shahinshabab/Attendance-Project/docs/tft-screens.png

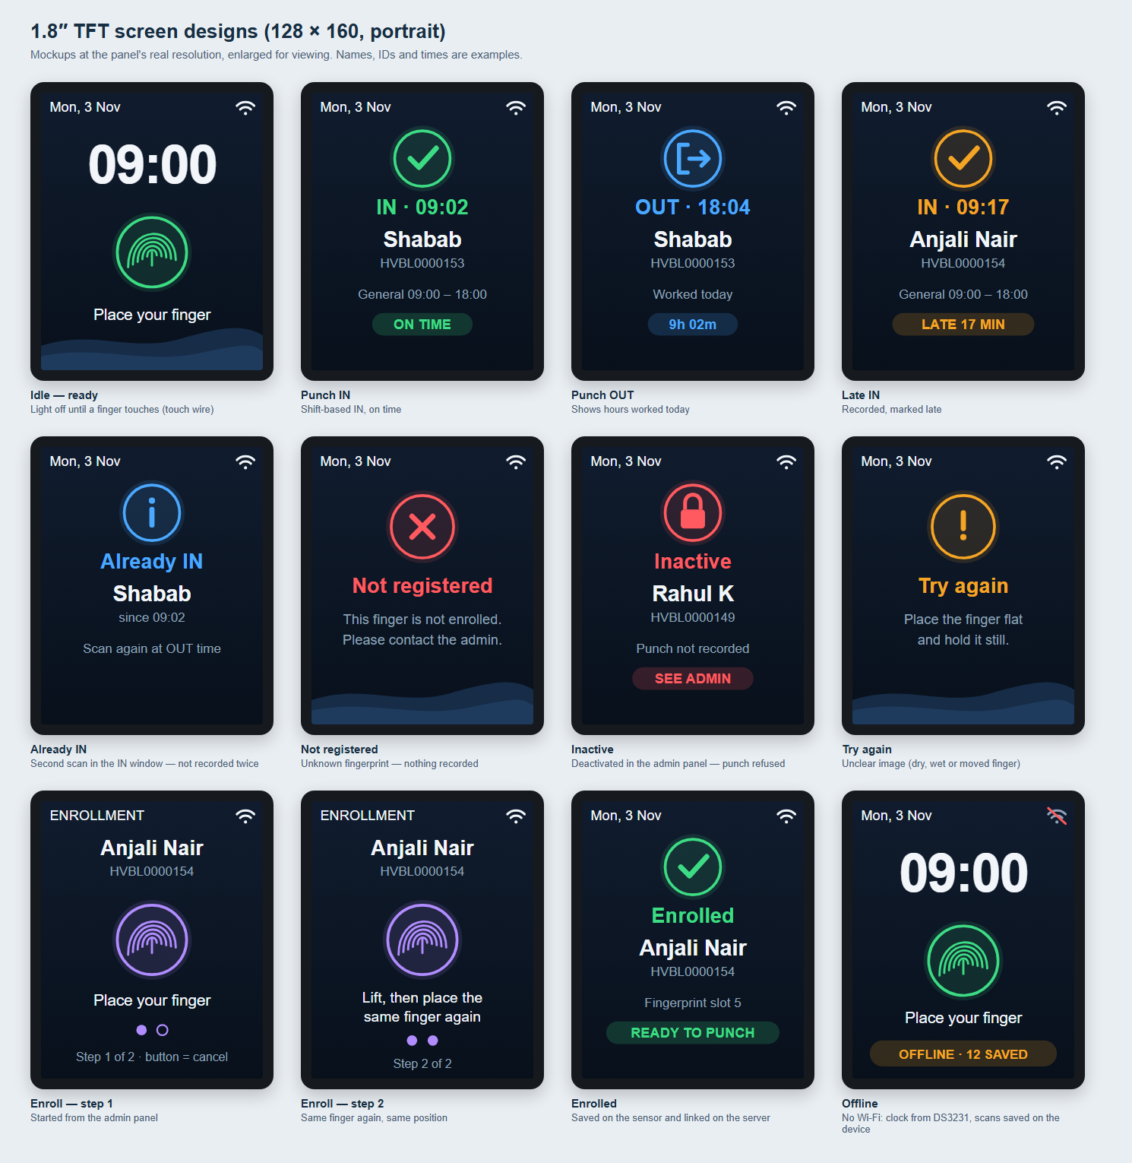
docs/tft-screens.png
