shahinshabab/Attendance-Project/docs/wiring.png

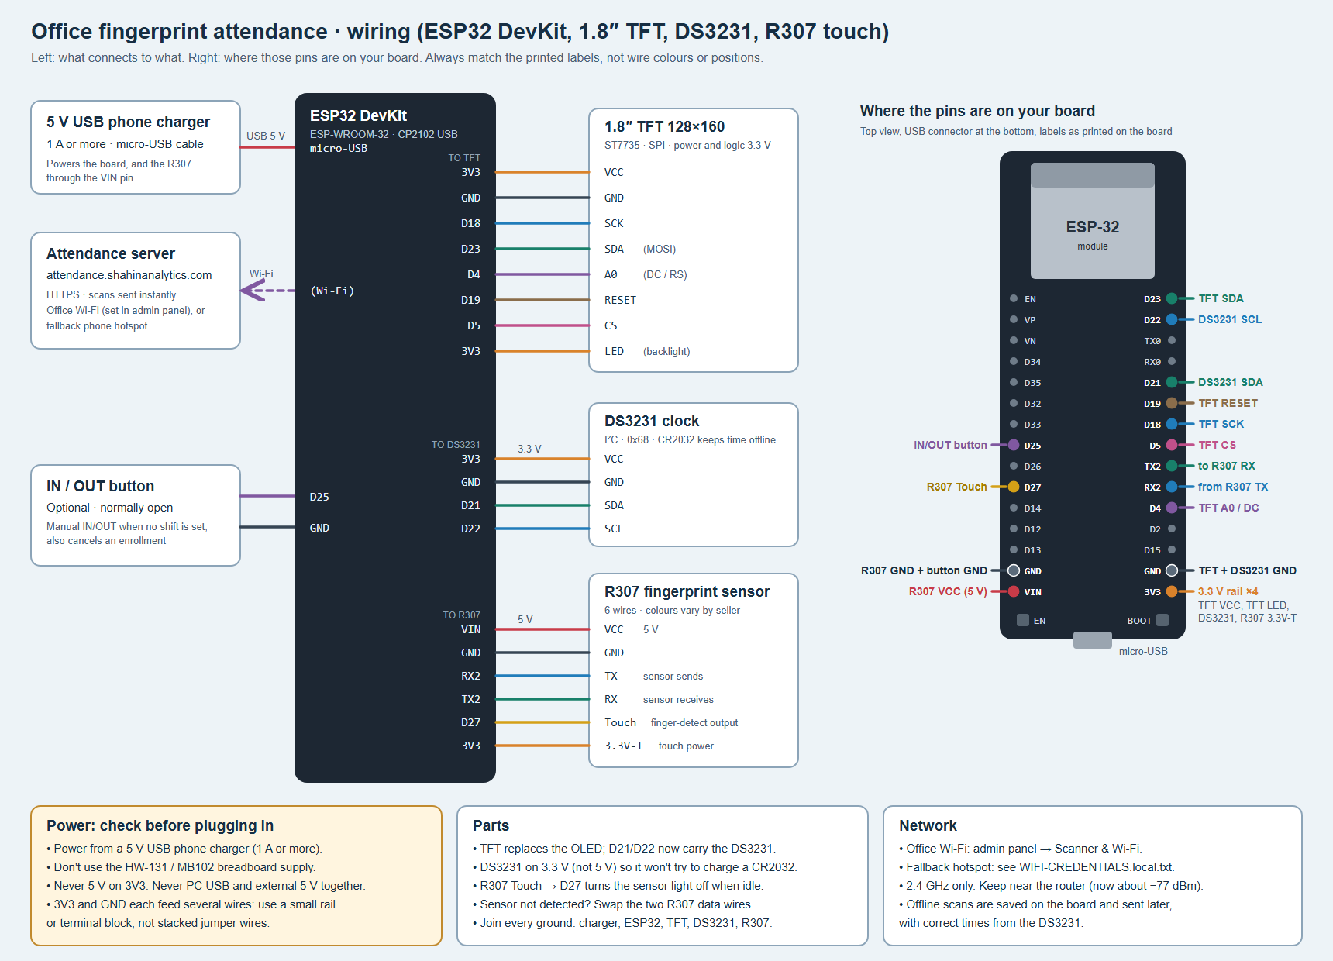
docs/wiring.png
