shahinshabab/Attendance-Project/pcb/attendance-board/attendance-board-schematic.pdf

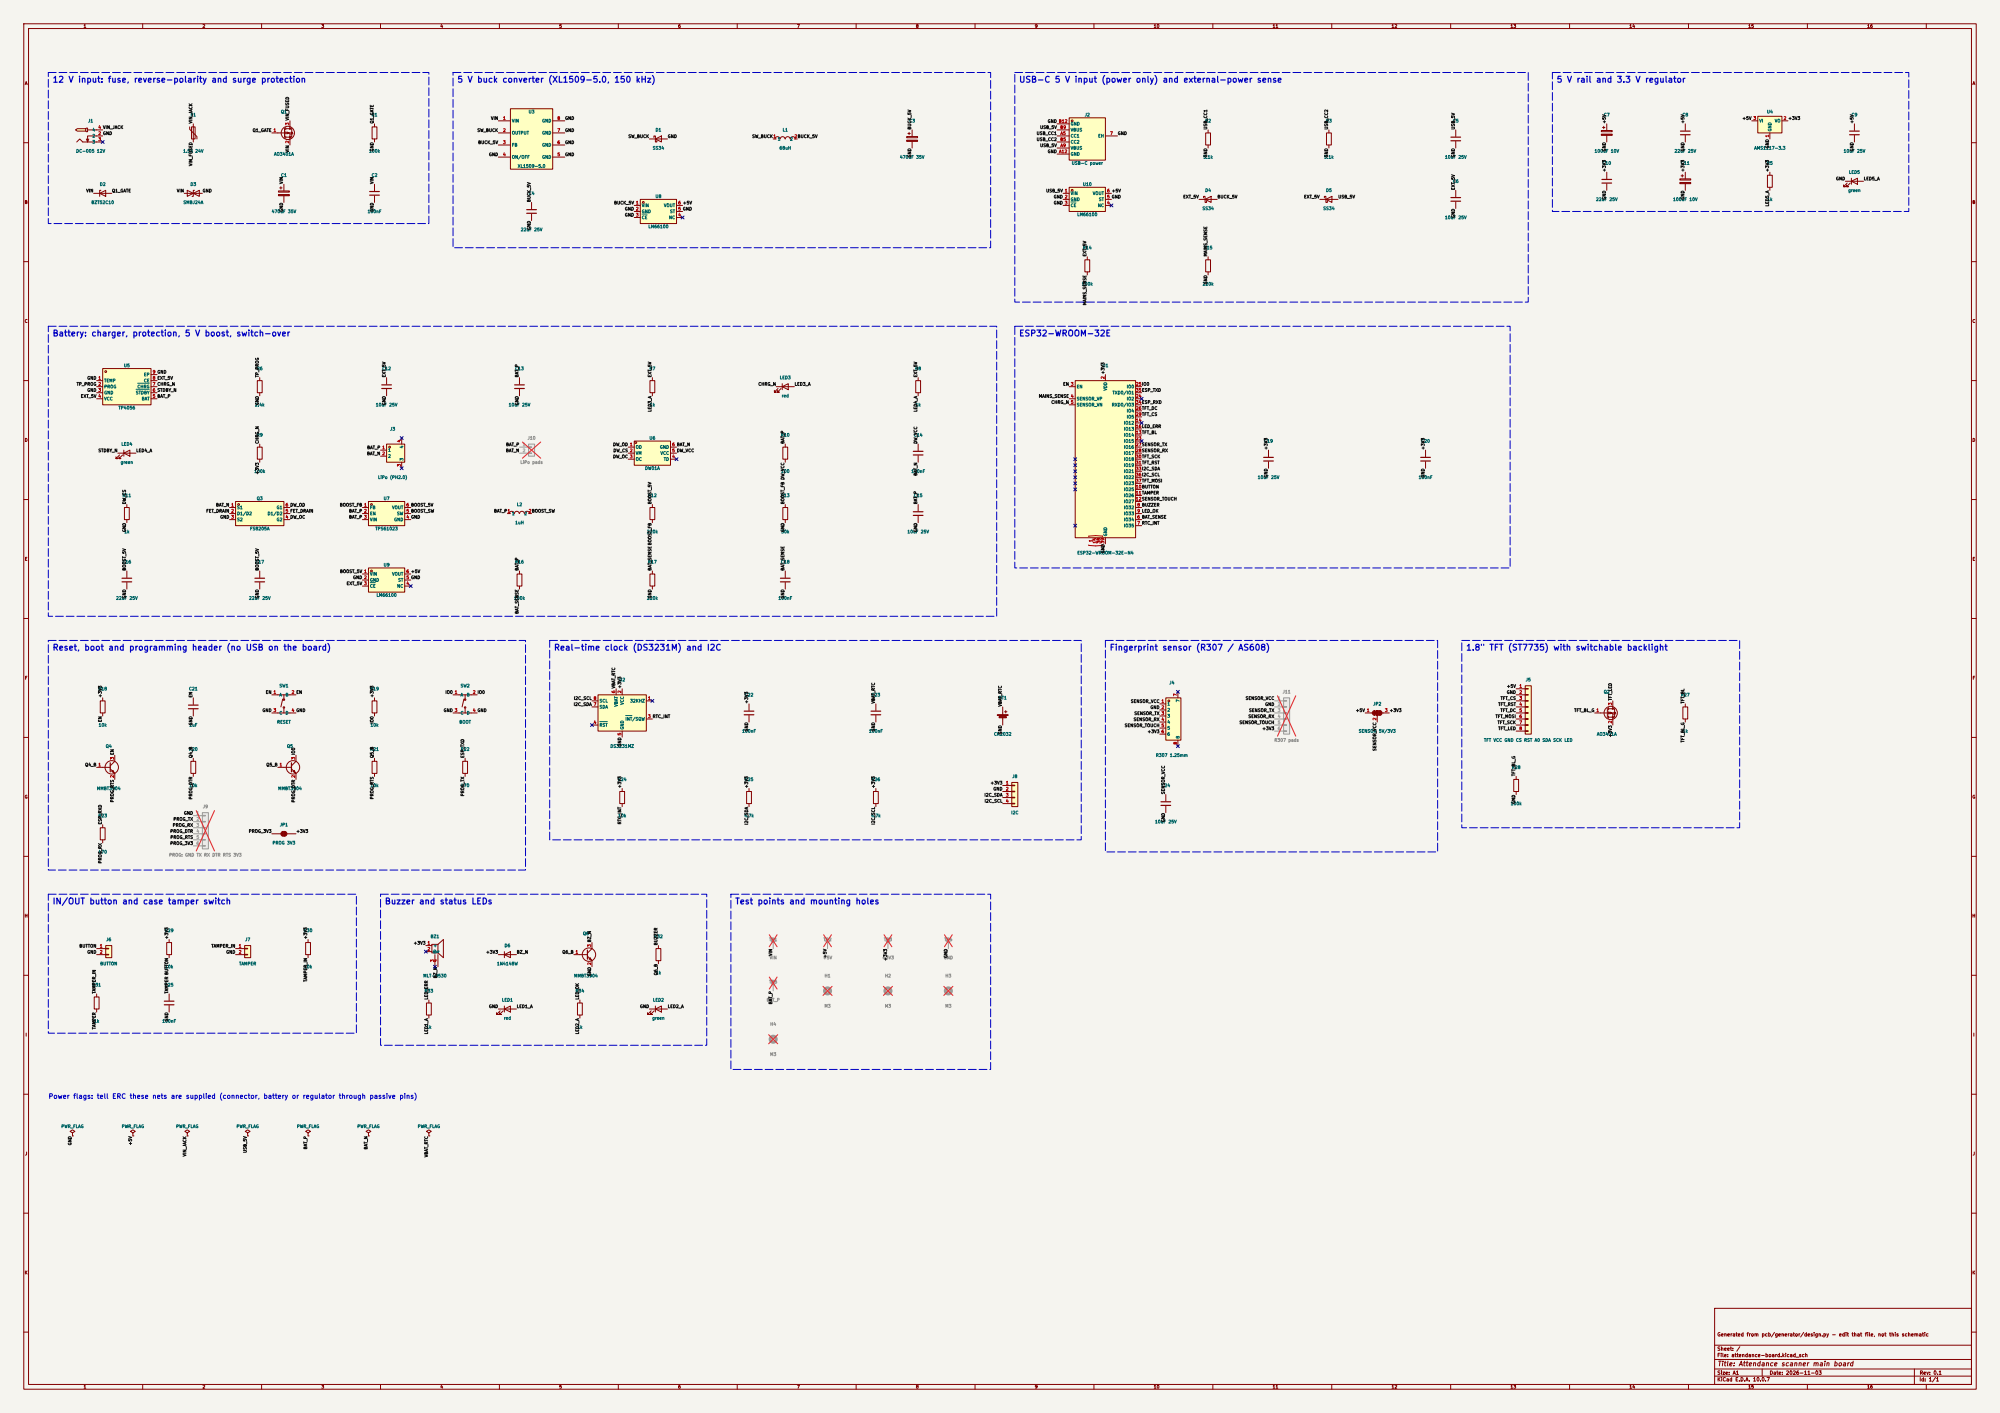
[picture p3: page 1]

12 V input: fuse, reverse-polarity and surge protection

Battery: charger, protection, 5 V boost, switch-over

TFT VCC GND CS RST A0 SDA SCK LED

J9 PROG: GND TX RX DTR RTS 3V3 R23

Test points and mounting holes

GND +3V3 TAMPER GND BUTTON TAMPER TAMPER_IN

Power flags: tell ERC these nets are supplied (connector, battery or regulator through passive pins)

Generated from pcb/generator/design.py - edit that file, not this schematic

Sheet: /
File: attendance-board.kicad_sch
Title: Attendance scanner main board

Size: A1 | Rev: 0.1
KiCad E.D.A. 10.0.7 | Id: 1/1
