shahinshabab/Attendance-Project/pcb/attendance-board/attendance-board.kicad_sch

## KiCad design pcb/attendance-board/attendance-board.kicad_sch (2026-11-03)

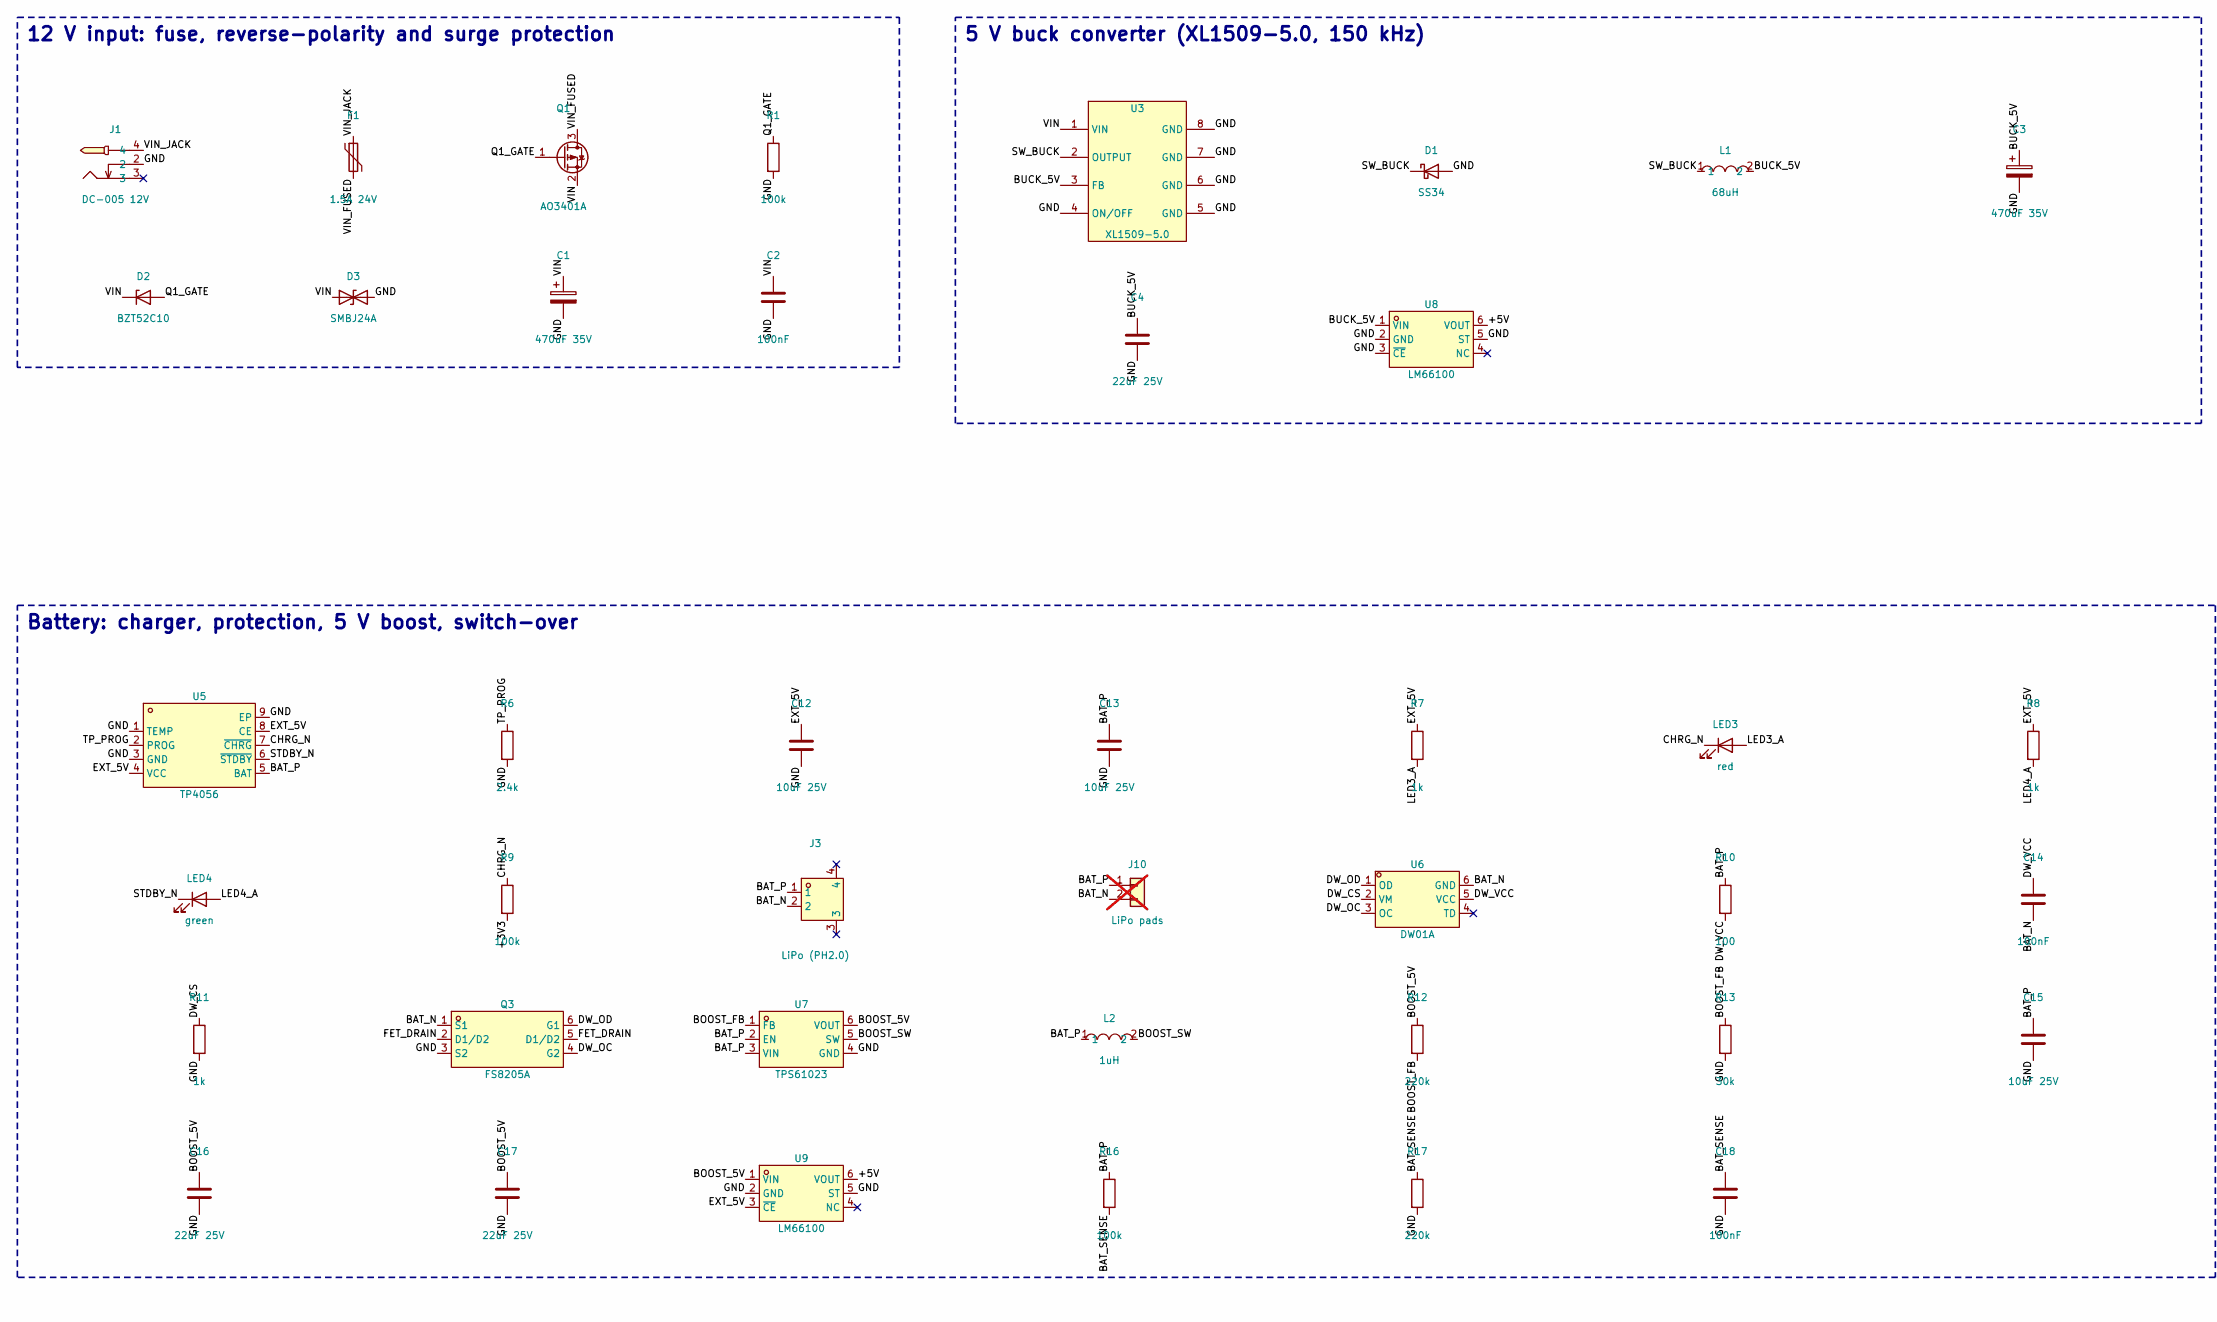
[picture p4: schematic attendance-board.kicad_sch, part in row 1, column 1]

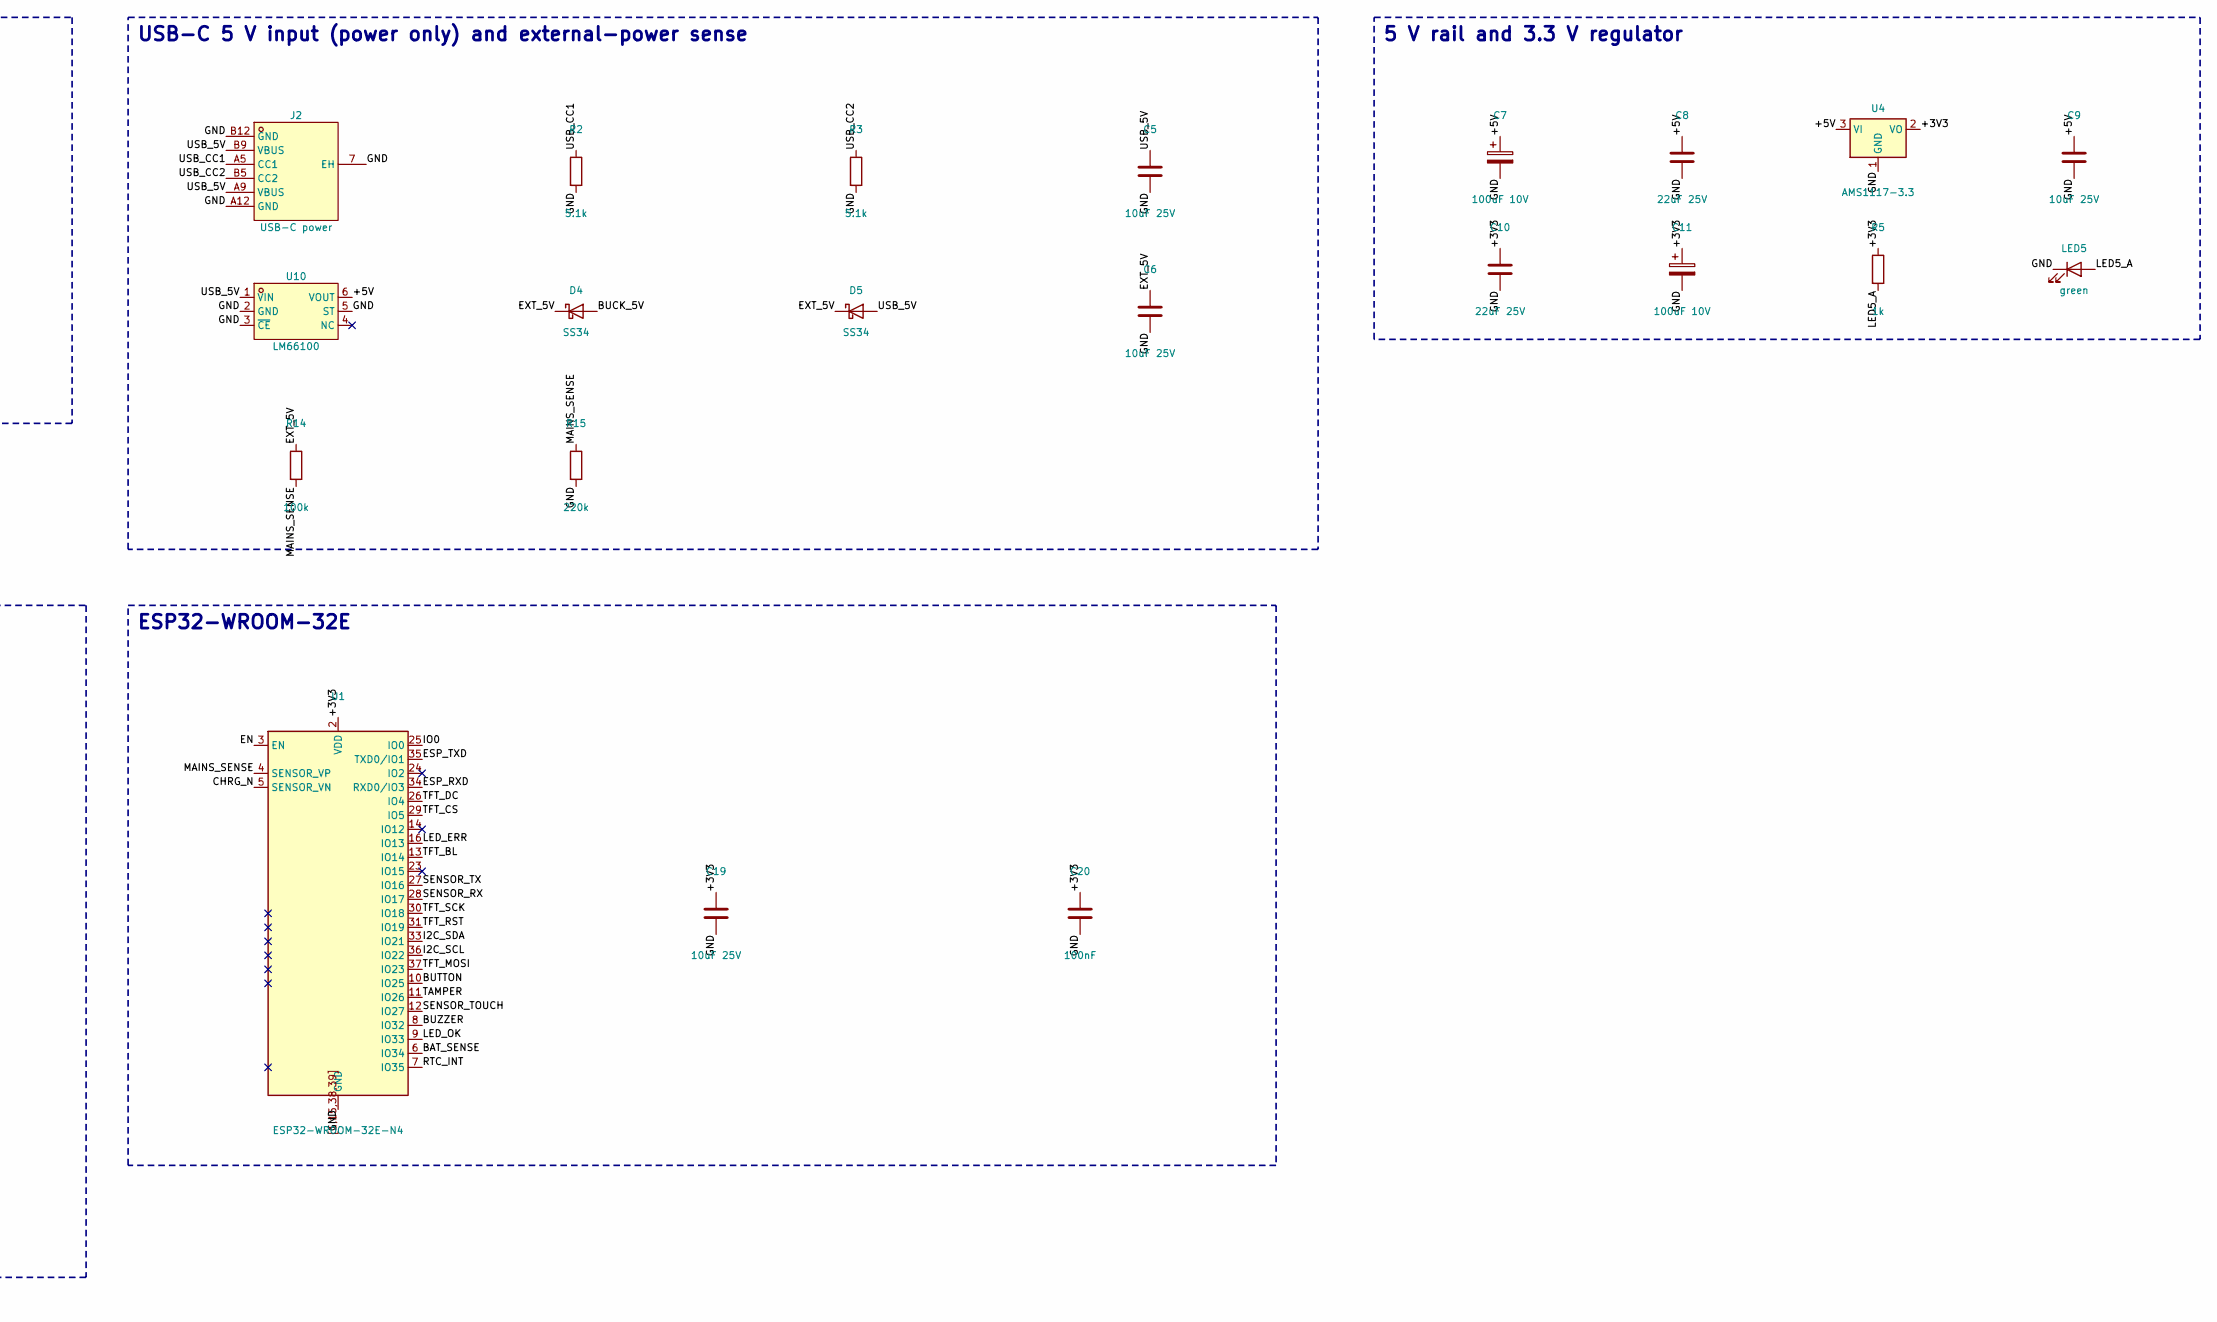
[picture p5: schematic attendance-board.kicad_sch, part in row 1, column 2]

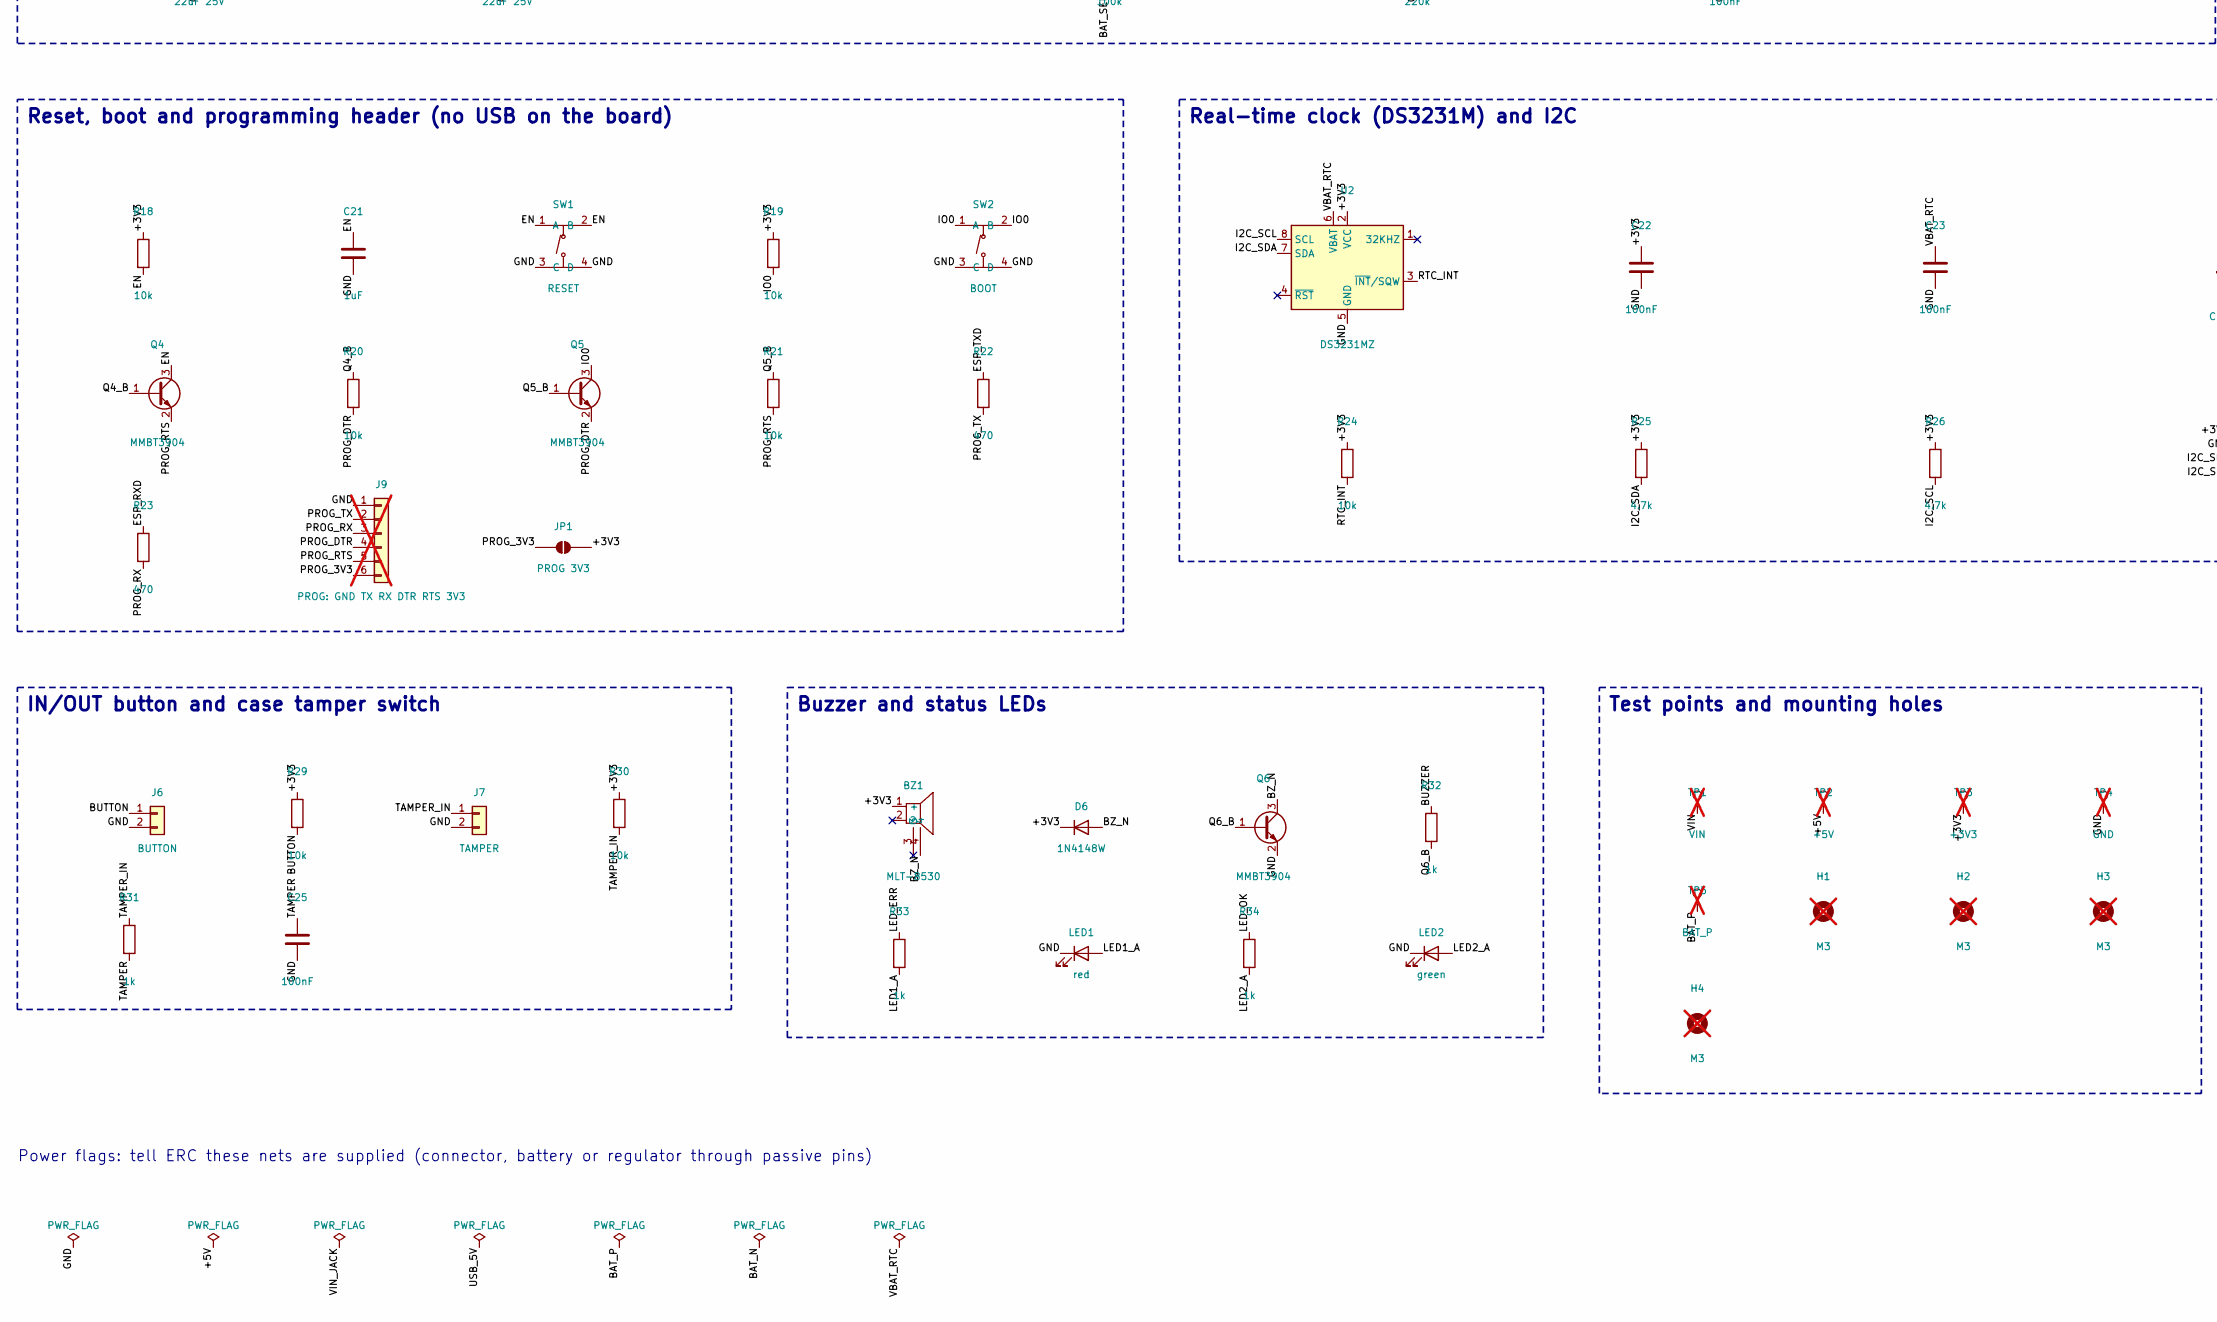
[picture p6: schematic attendance-board.kicad_sch, part in row 2, column 1]

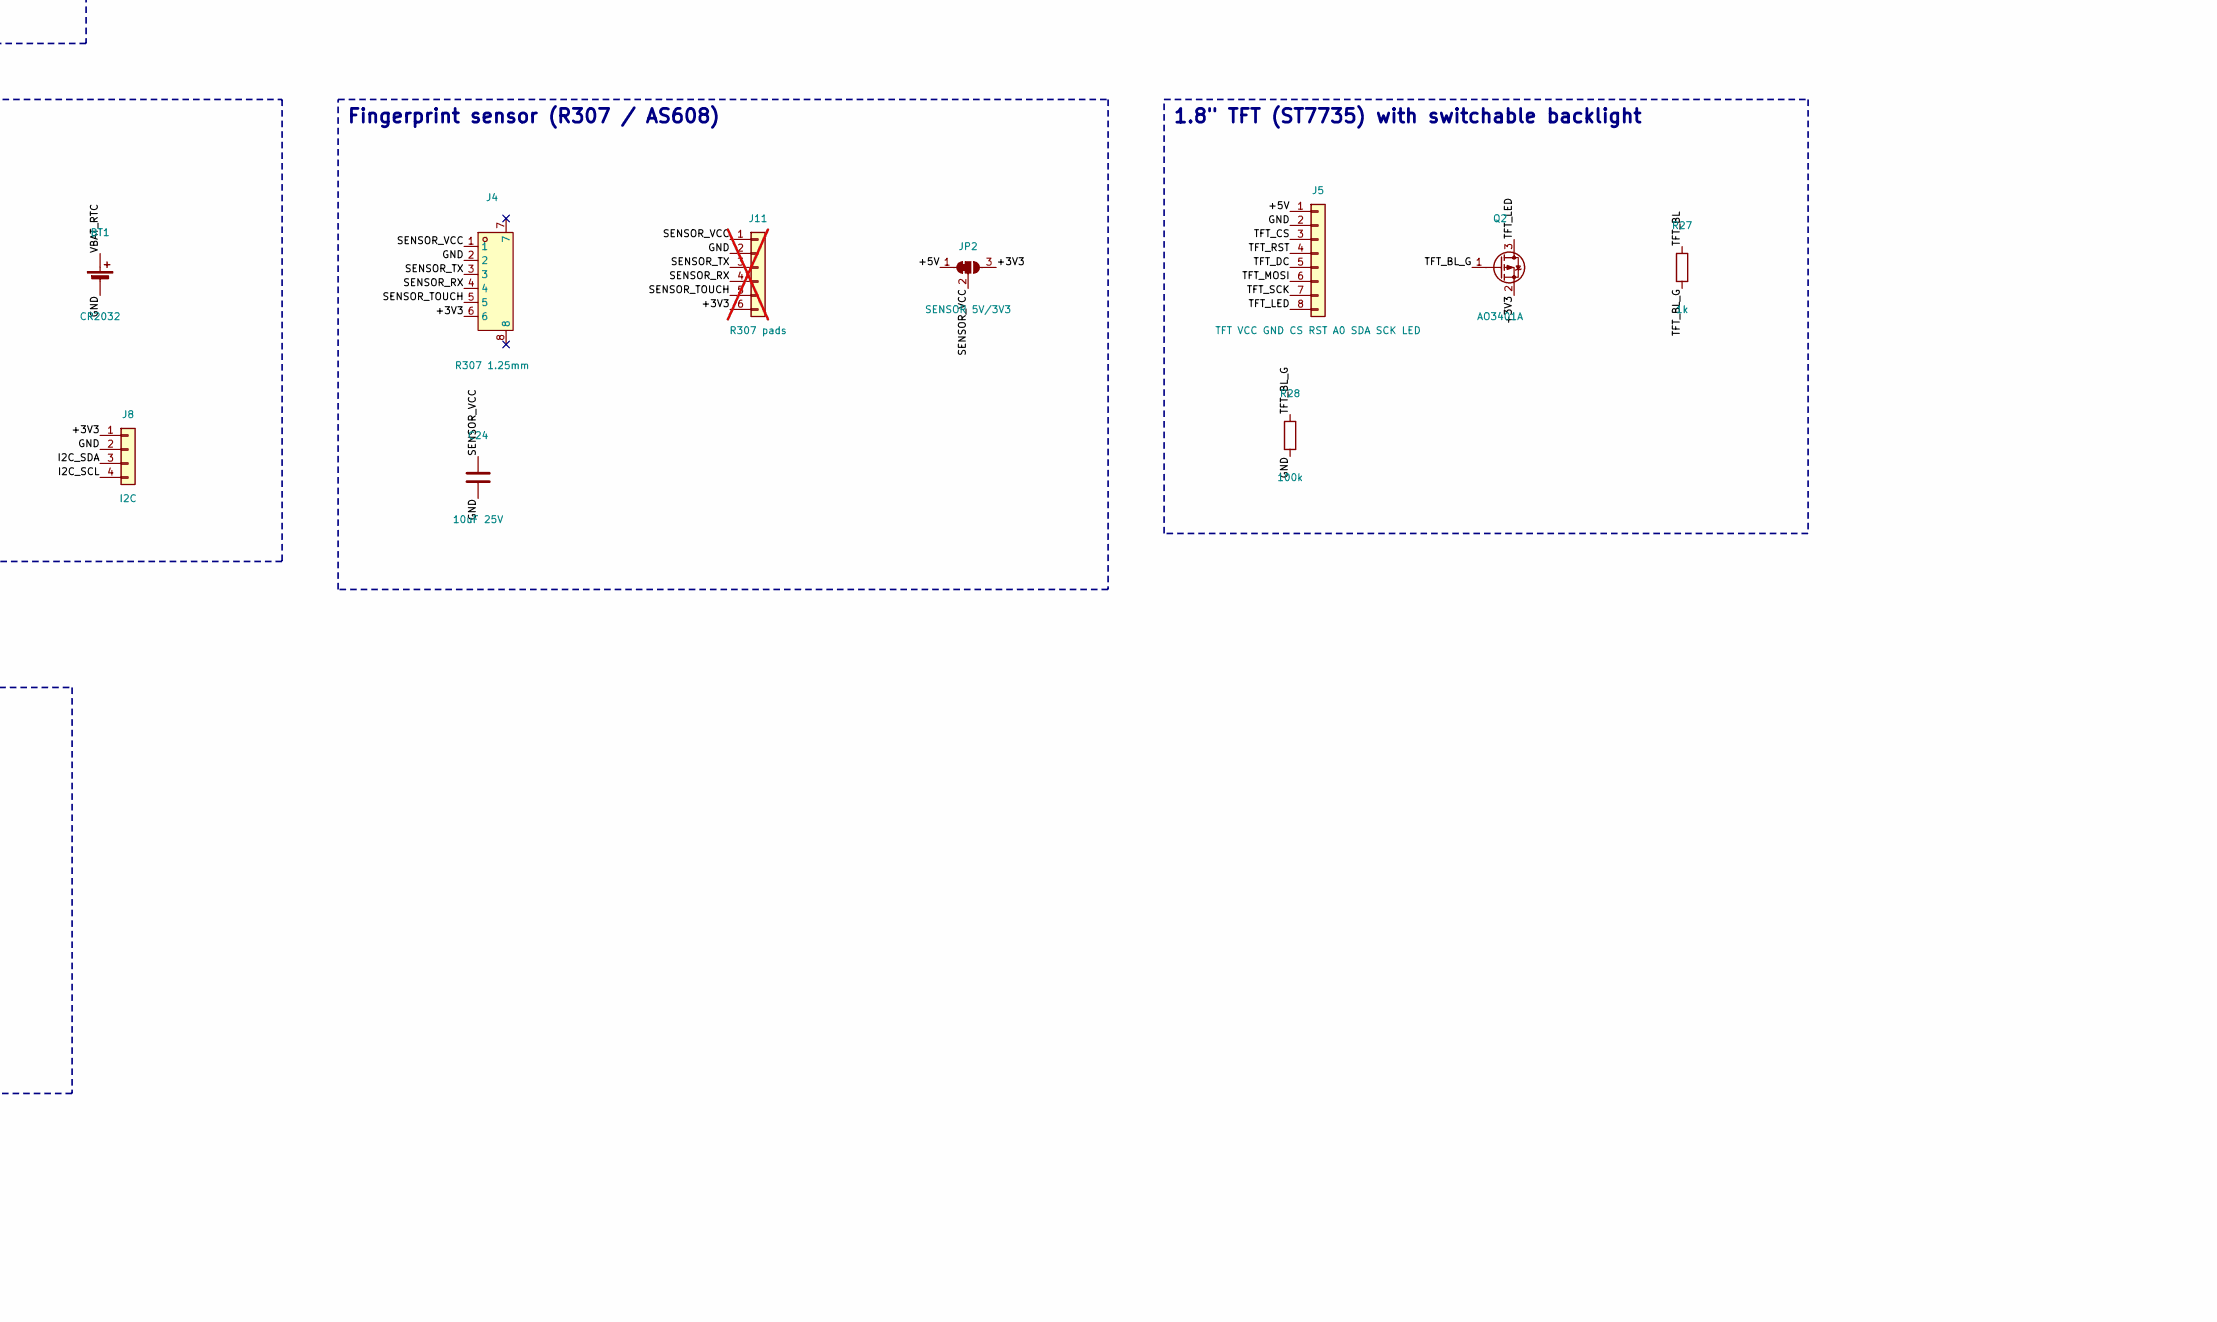
[picture p7: schematic attendance-board.kicad_sch, part in row 2, column 2]

Parts:
BT1: CR2032; BatteryHolder_Keystone_3034_1x20mm; LCSC C5213768
BZ1: MLT-8530; BUZ-SMD_4P-L8.5-W8.5-P8.50-BR; LCSC C94599
C1, C3: 470uF 35V; CP_Elec_10x10; LCSC C976030
C2, C14, C18, C20, C22, C23, C25: 100nF; C_0603_1608Metric; LCSC C14663
C4, C8, C10, C16, C17: 22uF 25V; C_0805_2012Metric; LCSC C45783
C5, C6, C9, C12, C13, C15, C19, C24: 10uF 25V; C_0805_2012Metric; LCSC C15850
C7, C11: 100uF 10V; CP_EIA-3528-21_Kemet-B; LCSC C129567
C21: 1uF; C_0603_1608Metric; LCSC C15849
D1, D4, D5: SS34; D_SMA; LCSC C8678
D2: BZT52C10; D_SOD-123; LCSC C173431
D3: SMBJ24A; D_SMB; LCSC C87268
D6: 1N4148W; D_SOD-123; LCSC C81598
F1: 1.5A 24V; Fuse_1812_4532Metric; LCSC C32404
H1, H2, H3, H4: M3; MountingHole_3.2mm_M3; not fitted
J1: DC-005 12V; DC-IN-TH_DC-005-5.5-2.0; LCSC C16214
J2: USB-C power; TYPE-C-SMD_TYPE-C-6P_1; LCSC C456012
J3: LiPo (PH2.0); CONN-SMD_PH2.0-1X2PW; LCSC C722761
J4: R307 1.25mm; CONN-SMD_6P-P1.25_XUNPU_WAFER-MX1.25-6PLB; LCSC C3029354
J5: TFT VCC GND CS RST A0 SDA SCK LED; PinSocket_1x08_P2.54mm_Vertical; LCSC C42431840
J6: BUTTON; JST_XH_B2B-XH-A_1x02_P2.50mm_Vertical; LCSC C158012
J7: TAMPER; JST_XH_B2B-XH-A_1x02_P2.50mm_Vertical; LCSC C158012
J8: I2C; JST_XH_B4B-XH-A_1x04_P2.50mm_Vertical; LCSC C144395
J9: PROG: GND TX RX DTR RTS 3V3; PinHeader_1x06_P2.54mm_Vertical; not fitted
J10: LiPo pads; SolderWire-0.5sqmm_1x02_P4.6mm_D0.9mm_OD2.1mm; not fitted
J11: R307 pads; PinHeader_1x06_P2.54mm_Vertical; not fitted
JP1: PROG 3V3; SolderJumper-2_P1.3mm_Open_RoundedPad1.0x1.5mm
JP2: SENSOR 5V/3V3; SolderJumper-3_P1.3mm_Bridged12_RoundedPad1.0x1.5mm
L1: 68uH; IND-SMD_L8.0-W8.0_FNR80XXS; LCSC C168140
L2: 1uH; IND-SMD_L4.0-W4.0_PRS4018; LCSC C96152
LED1, LED3: red; LED_0805_2012Metric; LCSC C84256
LED2, LED4, LED5: green; LED_0805_2012Metric; LCSC C84260
Q1, Q2: AO3401A; SOT-23; LCSC C15127
Q3: FS8205A; SOT-23-6_L2.9-W1.6-P0.95-LS2.8-BR; LCSC C2830320
Q4, Q5, Q6: MMBT3904; SOT-23; LCSC C20526
R1, R9, R14, R16, R28: 100k; R_0603_1608Metric; LCSC C25803
R2, R3: 5.1k; R_0603_1608Metric; LCSC C23186
R5, R7, R8, R11, R27, R31, R32, R33, R34: 1k; R_0603_1608Metric; LCSC C21190
R6: 2.4k; R_0603_1608Metric; LCSC C22940
R10: 100; R_0603_1608Metric; LCSC C22775
R12, R15, R17: 220k; R_0603_1608Metric; LCSC C22961
R13: 30k; R_0603_1608Metric; LCSC C22984
R18, R19, R20, R21, R24, R29, R30: 10k; R_0603_1608Metric; LCSC C25804
R22, R23: 470; R_0603_1608Metric; LCSC C23179
R25, R26: 4.7k; R_0603_1608Metric; LCSC C23162
SW1: RESET; SW-SMD_4P-L5.1-W5.1-P3.70-LS6.5-TL_H1.5; LCSC C318884
SW2: BOOT; SW-SMD_4P-L5.1-W5.1-P3.70-LS6.5-TL_H1.5; LCSC C318884
TP1: VIN; TestPoint_Pad_D1.5mm; not fitted
TP2: +5V; TestPoint_Pad_D1.5mm; not fitted
TP3: +3V3; TestPoint_Pad_D1.5mm; not fitted
TP4: GND; TestPoint_Pad_D1.5mm; not fitted
TP5: BAT_P; TestPoint_Pad_D1.5mm; not fitted
U1: ESP32-WROOM-32E-N4; ESP32-WROOM-32E; LCSC C701341
U2: DS3231MZ; SOIC-8_3.9x4.9mm_P1.27mm; LCSC C107410
U3: XL1509-5.0; SOIC-8_L5.0-W4.0-P1.27-LS6.0-BL; LCSC C61063
U4: AMS1117-3.3; SOT-223-3_TabPin2; LCSC C6186
U5: TP4056; ESOP-8_L4.9-W3.9-P1.27-LS6.0-BL-EP; LCSC C725790
U6: DW01A; SOT-23-6_L2.9-W1.6-P0.95-LS2.8-BL; LCSC C351410
U7: TPS61023; SOT-563_L1.6-W1.2-P0.50-LS1.6-BR; LCSC C919459
U8, U9, U10: LM66100; SC-70-6_L2.0-W1.3-P0.65-LS2.1-BL; LCSC C2869734

Connections:
+3V3: BZ1.1 (+), C10.1, C11.1, C19.1, C20.1, C22.1, D6.1 (K), J4.6, J8.1, J11.6, JP1.2 (B), JP2.3 (B), Q2.2 (S), R5.1, R9.2, R18.1, R19.1, R24.1, R25.1, R26.1, R29.1, R30.1, TP3.1, U1.2 (VDD), U2.2 (VCC), U4.2 (VO)
+5V: C7.1, C8.1, C9.1, J5.1, JP2.1 (A), TP2.1, U4.3 (VI), U8.6 (VOUT), U9.6 (VOUT), U10.6 (VOUT)
BAT_N: C14.2, J3.2, J10.2, Q3.1 (S1), U6.6 (GND)
BAT_P: C13.1, C15.1, J3.1, J10.1, L2.1, R10.1, R16.1, TP5.1, U5.5 (BAT), U7.2 (EN), U7.3 (VIN)
BAT_SENSE: C18.1, R16.2, R17.1, U1.6 (IO34)
BOOST_5V: C16.1, C17.1, R12.1, U7.6 (VOUT), U9.1 (VIN)
BOOST_FB: R12.2, R13.1, U7.1 (FB)
BOOST_SW: L2.2, U7.5 (SW)
BUCK_5V: C3.1, C4.1, D4.2 (A), L1.2, U3.3 (FB), U8.1 (VIN)
BUTTON: J6.1, R29.2, U1.10 (IO25)
BUZZER: R32.1, U1.8 (IO32)
BZ_N: BZ1.4, D6.2 (A), Q6.3 (C)
CHRG_N: LED3.1 (K), R9.1, U1.5 (SENSOR_VN), U5.7 (~CHRG)
DW_CS: R11.1, U6.2 (VM)
DW_OC: Q3.4 (G2), U6.3 (OC)
DW_OD: Q3.6 (G1), U6.1 (OD)
DW_VCC: C14.1, R10.2, U6.5 (VCC)
EN: C21.1, Q4.3 (C), R18.2, SW1.1 (A), SW1.2 (B), U1.3 (EN)
ESP_RXD: R23.1, U1.34 (RXD0/IO3)
ESP_TXD: R22.1, U1.35 (TXD0/IO1)
EXT_5V: C6.1, C12.1, D4.1 (K), D5.1 (K), R7.1, R8.1, R14.1, U5.4 (VCC), U5.8 (CE), U9.3 (~CE)
FET_DRAIN: Q3.2 (D1/D2), Q3.5 (D1/D2)
GND: BT1.2 (-), C1.2, C2.2, C3.2, C4.2, C5.2, C6.2, C7.2, C8.2, C9.2, C10.2, C11.2, C12.2, C13.2, C15.2, C16.2, C17.2, C18.2, C19.2, C20.2, C21.2, C22.2, C23.2, C24.2, C25.2, D1.2 (A), D3.2 (A2), J1.2, J2.7 (EH), J2.A12 (GND), J2.B12 (GND), J4.2, J5.2, J6.2, J7.2, J8.2, J9.1, J11.2, LED1.1 (K), LED2.1 (K), LED5.1 (K), Q3.3 (S2), Q6.2 (E), R1.2, R2.2, R3.2, R6.2, R11.2, R13.2, R15.2, R17.2, R28.2, SW1.3 (C), SW1.4 (D), SW2.3 (C), SW2.4 (D), TP4.1, U1.[1,15,38,39] (GND), U2.5 (GND), U3.4 (ON/OFF), U3.5 (GND), U3.6 (GND), U3.7 (GND), U3.8 (GND), U4.1 (GND), U5.1 (TEMP), U5.3 (GND), U5.9 (EP), U7.4 (GND), U8.2 (GND), U8.3 (~CE), U8.5 (ST), U9.2 (GND), U9.5 (ST), U10.2 (GND), U10.3 (~CE), U10.5 (ST)
I2C_SCL: J8.4, R26.2, U1.36 (IO22), U2.8 (SCL)
I2C_SDA: J8.3, R25.2, U1.33 (IO21), U2.7 (SDA)
IO0: Q5.3 (C), R19.2, SW2.1 (A), SW2.2 (B), U1.25 (IO0)
LED1_A: LED1.2 (A), R33.2
LED2_A: LED2.2 (A), R34.2
LED3_A: LED3.2 (A), R7.2
LED4_A: LED4.2 (A), R8.2
LED5_A: LED5.2 (A), R5.2
LED_ERR: R33.1, U1.16 (IO13)
LED_OK: R34.1, U1.9 (IO33)
MAINS_SENSE: R14.2, R15.1, U1.4 (SENSOR_VP)
PROG_3V3: J9.6, JP1.1 (A)
PROG_DTR: J9.4, Q5.2 (E), R20.2
PROG_RTS: J9.5, Q4.2 (E), R21.2
PROG_RX: J9.3, R23.2
PROG_TX: J9.2, R22.2
Q1_GATE: D2.2 (A), Q1.1 (G), R1.1
Q4_B: Q4.1 (B), R20.1
Q5_B: Q5.1 (B), R21.1
Q6_B: Q6.1 (B), R32.2
RTC_INT: R24.2, U1.7 (IO35), U2.3 (~INT/SQW)
SENSOR_RX: J4.4, J11.4, U1.28 (IO17)
SENSOR_TOUCH: J4.5, J11.5, U1.12 (IO27)
SENSOR_TX: J4.3, J11.3, U1.27 (IO16)
SENSOR_VCC: C24.1, J4.1, J11.1, JP2.2 (C)
STDBY_N: LED4.1 (K), U5.6 (~STDBY)
SW_BUCK: D1.1 (K), L1.1, U3.2 (OUTPUT)
TAMPER: C25.1, R31.2, U1.11 (IO26)
TAMPER_IN: J7.1, R30.2, R31.1
TFT_BL: R27.1, U1.13 (IO14)
TFT_BL_G: Q2.1 (G), R27.2, R28.1
TFT_CS: J5.3, U1.29 (IO5)
TFT_DC: J5.5, U1.26 (IO4)
TFT_LED: J5.8, Q2.3 (D)
TFT_MOSI: J5.6, U1.37 (IO23)
TFT_RST: J5.4, U1.31 (IO19)
TFT_SCK: J5.7, U1.30 (IO18)
TP_PROG: R6.1, U5.2 (PROG)
USB_5V: C5.1, D5.2 (A), J2.A9 (VBUS), J2.B9 (VBUS), U10.1 (VIN)
USB_CC1: J2.A5 (CC1), R2.1
USB_CC2: J2.B5 (CC2), R3.1
VBAT_RTC: BT1.1 (+), C23.1, U2.6 (VBAT)
VIN: C1.1, C2.1, D2.1 (K), D3.1 (A1), Q1.2 (S), TP1.1, U3.1 (VIN)
VIN_FUSED: F1.2, Q1.3 (D)
VIN_JACK: F1.1, J1.4

Notes on the sheet:
12 V input: fuse, reverse-polarity and surge protection
5 V buck converter (XL1509-5.0, 150 kHz)
USB-C 5 V input (power only) and external-power sense
5 V rail and 3.3 V regulator
Battery: charger, protection, 5 V boost, switch-over
ESP32-WROOM-32E
Reset, boot and programming header (no USB on the board)
Real-time clock (DS3231M) and I2C
Fingerprint sensor (R307 / AS608)
1.8" TFT (ST7735) with switchable backlight
IN/OUT button and case tamper switch
Buzzer and status LEDs
Test points and mounting holes
Power flags: tell ERC these nets are supplied (connector, battery or regulator through passive pins)
