shahinshabab/Attendance-Project/(commit log)

2026-11-03 Office fingerprint attendance system (ESP32 + R307 + FastAPI)
    - ESP32 / NodeMCU firmware: R307 enrollment and matching, OLED status,
    offline flash queue, office Wi-Fi from the server with a built-in
    fallback hotspot, server-requested enrollment, HTTPS with pinned roots
    - FastAPI + SQLite server: staff, slot bindings, attendance, CSV export,
    scanner check-in, enrollment requests, Wi-Fi config
    - Admin panel with login sessions and live attendance (server-sent events)
    - Deployment scripts (systemd + Caddy), wiring diagram and docs, tests
    Secrets (.env, firmware config.h, Wi-Fi credentials) are git-ignored.
    [bootstrap.py, check_public.py, config.example.h, deploy.py, device.py]
2026-11-03 Add DS3231 clock, R307 touch wire, TFT designs and wiring
    - DS3231 (I2C D21/D22): system time is restored from it at boot, and
    verified server time corrects both the clock and the DS3231
    - R307 Touch output on D27: the sensor is read only while a finger
    touches it, so its light stays off when idle. The wire and its
    polarity are detected at boot; without it the firmware keeps polling
    - Scanner reports rtc/touch status to the server and over USB STATUS
    - Pin plan for a 1.8" ST7735 TFT (SPI D18/D23, CS D5, A0 D4, RESET D19)
    - 12 TFT screen mockups (docs/tft-screens.png) for approval
    - Wiring diagram and table updated for TFT, DS3231 and touch wires
    Firmware 0.4.0-dev; built for ESP32 and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
    [config.example.h, main.cpp]
2026-11-03 PCB: design specification and selected JLCPCB parts (stage 1)
    - pcb/README.md: requirements for a 70 x 110 mm main board with
    ESP32-WROOM-32E, on-board DS3231 clock, protected 12 V / USB-C power,
    LiPo battery backup, internal programming header, sensor and TFT
    connectors, and the GPIO map matching the firmware
    - pcb/parts.md: real LCSC parts with stock and prices (2026-11-03),
    Basic vs Extended, and a cost estimate
    - pcb/.gitignore: KiCad caches/backups and generated fabrication output
2026-11-03 PCB: schematic generated from a design-as-code description (stage 2)
    - pcb/generator/design.py: every component with symbol, footprint, LCSC
    part and pin -> net map (12 V input protection, XL1509 5 V buck,
    USB-C power-only input, LM66100 ideal-diode switch-over, TP4056 +
    DW01A/FS8205A + TPS61023 battery backup, AMS1117 3.3 V, ESP32-WROOM-32E,
    DS3231MZ, auto-program header, sensor/TFT/button/tamper connectors,
    buzzer and LEDs)
    - gen_schematic.py writes the KiCad 10 project, schematic and library
    tables; sexpr.py/symbols.py read KiCad libraries; fix_library.py
    normalises the easyeda2kicad-imported library
    - pcb/libraries: LCSC symbols/footprints (3D models git-ignored)
    - ERC: 0 e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
    [attendance-board.kicad_sch]
